davidkreidler/OpenCO2_Mini/pictures/graph.png

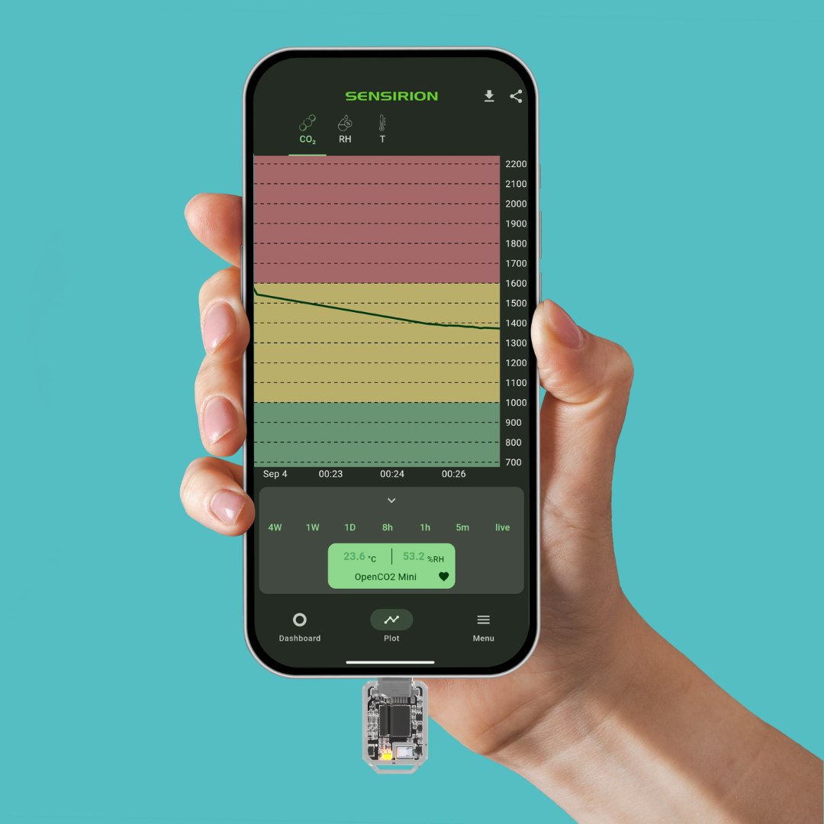
pictures/graph.png
