davidkreidler/OpenCO2_Mini/case/OpenCO2 mini case v2.1.obj

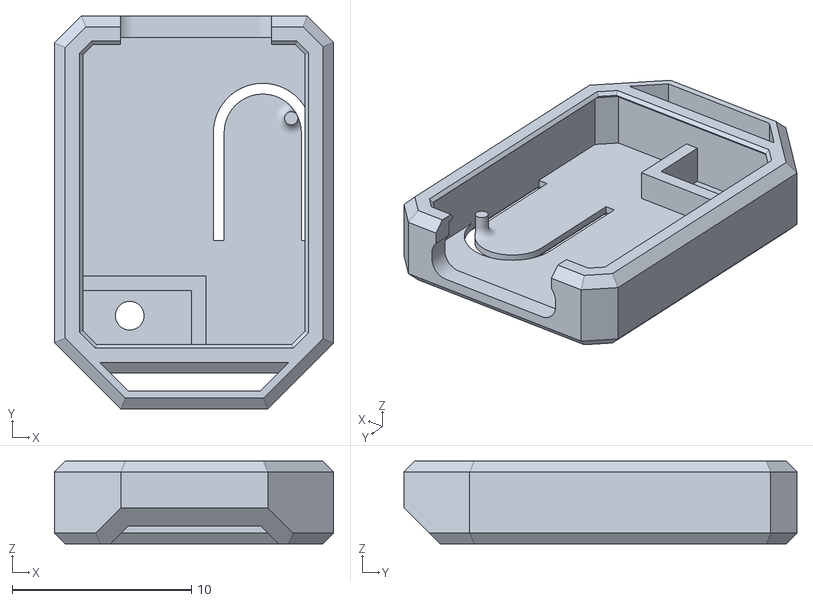
[picture p9: CAD file, 2026-01-30]
case/OpenCO2 mini case v2.1.obj
15.6 x 21.9 x 4.60
