davidkreidler/OpenCO2_Mini/schematic.pdf

## ESP32-S3 500mA LED: 20mA

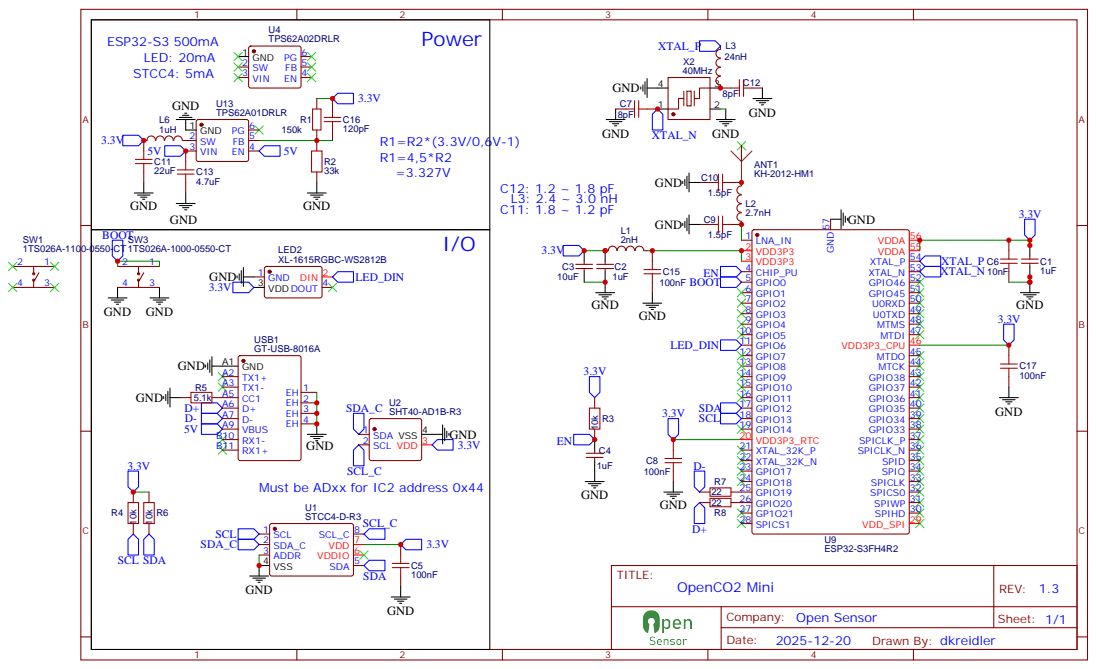
[picture p10: page 1]

Must be ADxx for IC2 address 0x44
