davidkreidler/OpenCO2_Mini/(commit log)

2025-10-27 v1.1 Sensor conditioning and recalibration option
    On boot perform STCC4 conditioning
    Blue LED color on before first measurement
    Option to manually force a recalibration via the APP
    Option to enable different LED colors via MYAM_LED_COLORS
    Serial print fixes for ProductId
    ESP32-S3 update to 3.3.2
    arduino-ble-gadget update to 1.5.0
    NimBLE-Arduino upgrade to 2.3.6
    [OpenCO2_Mini.ino]
2026-01-02 Switch to sensirion-upt library
2026-01-02 Update all graphics for PCB version 1.1
    25% smaller with optimized layout
    New Flyer, schematics
    Update readme
2026-01-05 Fix iOS myambiance app settings
    Reliability improvement of settings for wifi etc. showing up in iOS by increasing the awake time from 70 to 90 ms.
    [OpenCO2_Mini.ino]
2026-01-30 WiFi reconnect & build workflow update
    Try to reconnect every 15 sec in case wifi connection gets lost.
    ESP32 version update to 3.3.6
    Sensirion UTP bleServices include fix
    Build workflow now auto generates and uploads FIRMWARE.BIN with 80MHz frequency
    [OpenCO2_Mini.ino]
2026-01-30 Add Case 3D file
    [OpenCO2 mini case v2.1.obj]
2026-02-08 deviceInfoService for Name and FW version
2026-03-01 arduino-esp32 3.3.7 & Codestyle
2026-03-06 NimBLE-Arduino update
    https://github.com/h2zero/NimBLE-Arduino/releases/tag/2.3.8
2026-03-24 Sensor self-test
    Update firmware version to v1.6 and add a sensor self-test during setup. The code calls sensor.performSelfTest() and handles communication errors and test result bits by setting the status pixel to different colors:
    Raspberry-> communication error;
    Magenta -> supply voltage issue;
    Violet-> SHT Sensor not connected;
    Cyan-> Memory error;
    White-> other
    And entering light sleep to halt operation on failure. This surfaces hardware faults early and prevents normal operation when the sensor reports problems.
    [OpenCO2_Mini.ino]
